LohanAtapattu/Unic_Cass_IHP/docs/bandpass_filter_topology.png

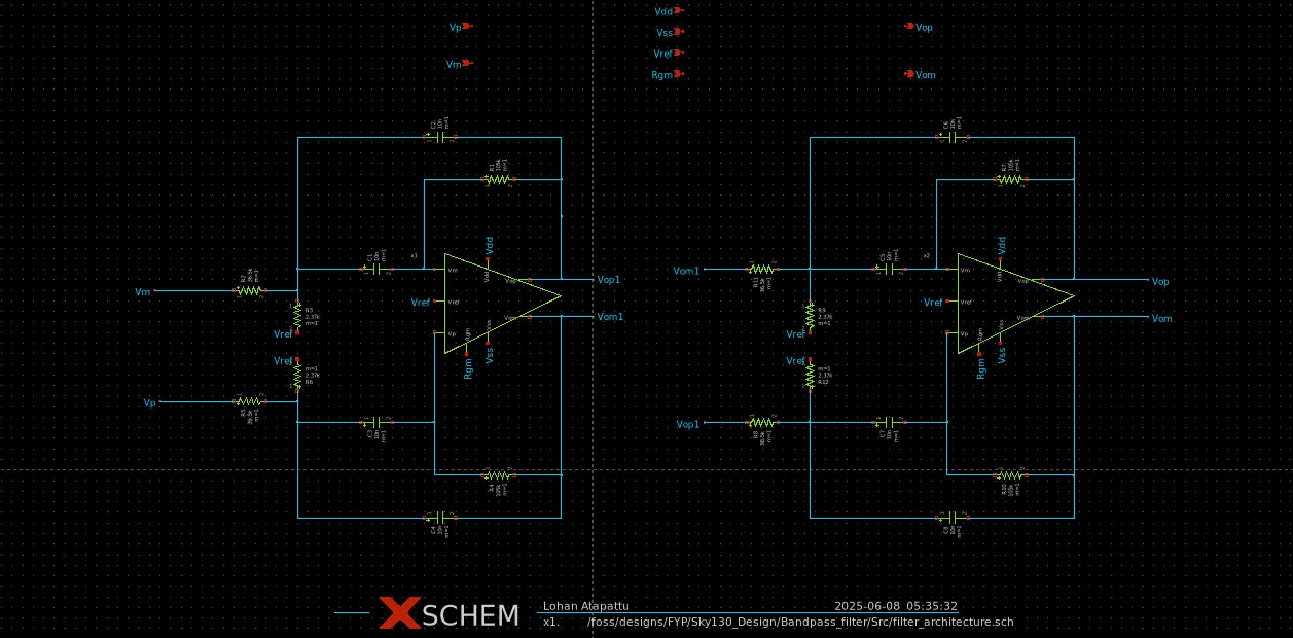
docs/bandpass_filter_topology.png
