LohanAtapattu/Unic_Cass_IHP/docs/cmrr_simulation.png

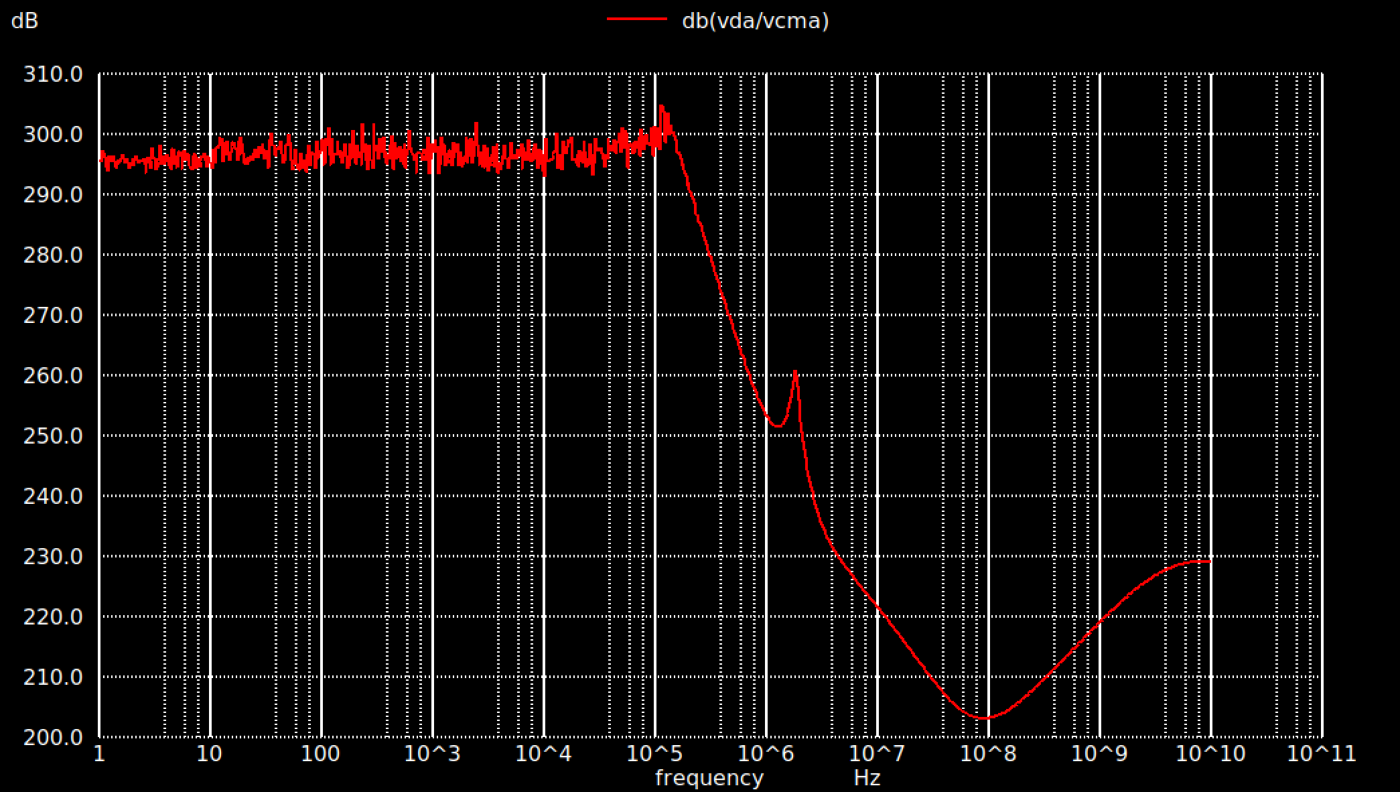
docs/cmrr_simulation.png
