LohanAtapattu/Unic_Cass_IHP/docs/Gain_Bandwidth_product.png

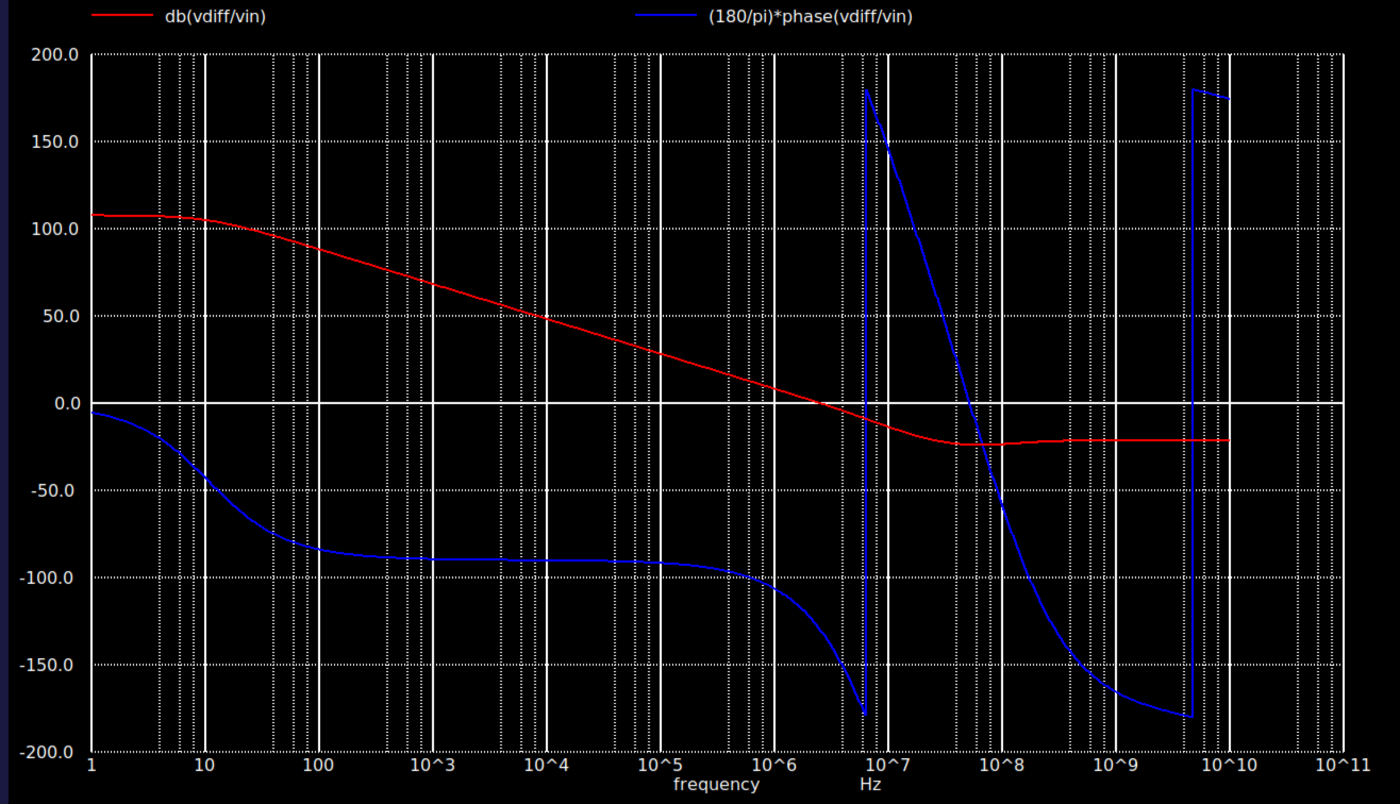
docs/Gain_Bandwidth_product.png
