LohanAtapattu/Unic_Cass_IHP/docs/Operational_amplifier.png

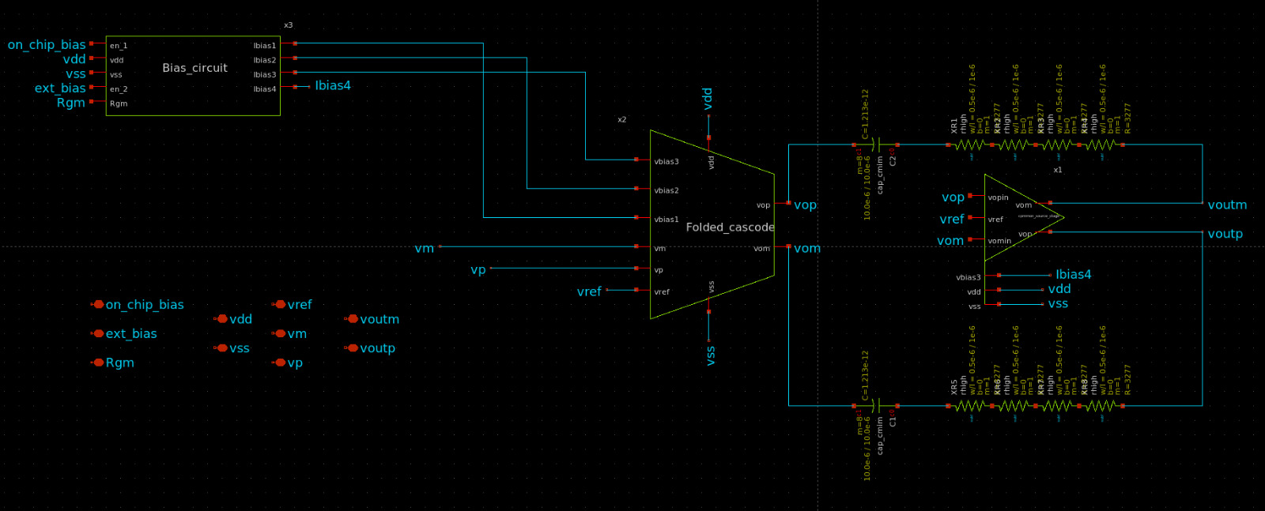
docs/Operational_amplifier.png
