LohanAtapattu/Unic_Cass_IHP/docs/bandpass_filter_testing_results.png

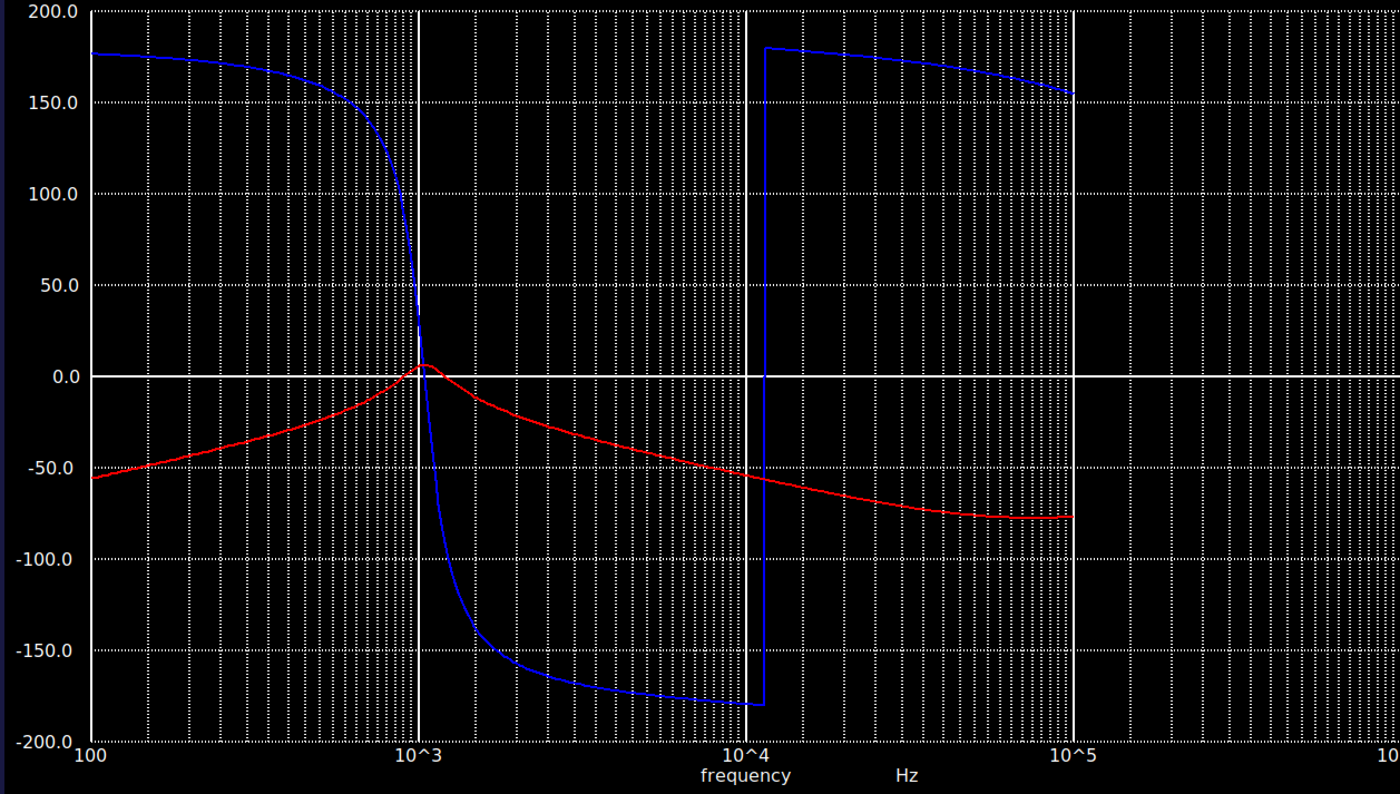
docs/bandpass_filter_testing_results.png
