LohanAtapattu/Unic_Cass_IHP/docs/impedance_measurement_ASIC.png

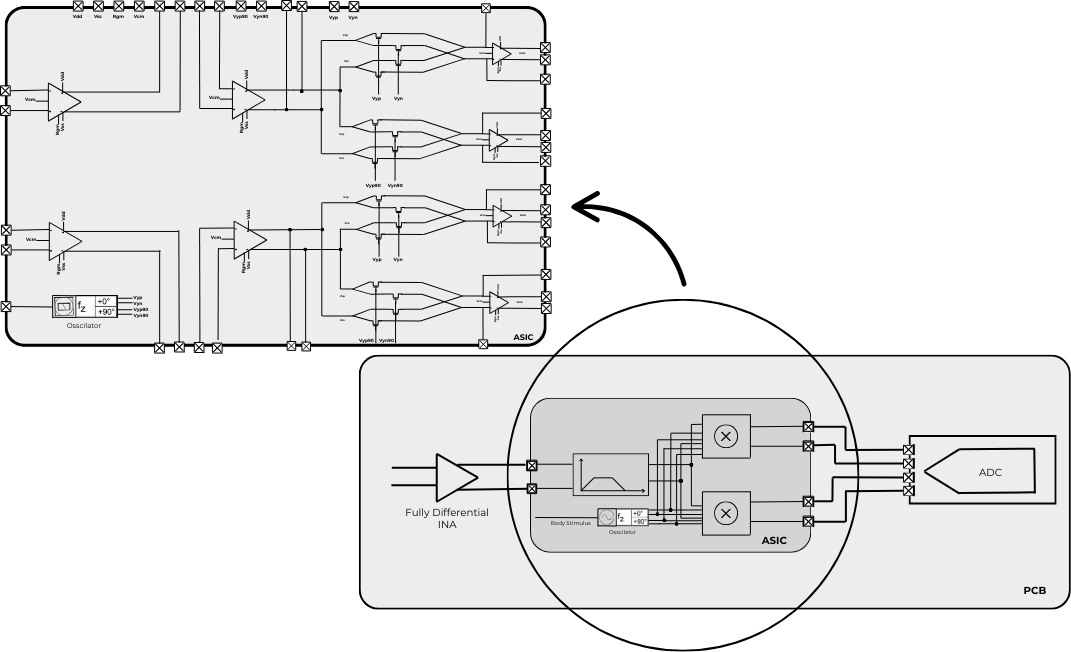
docs/impedance_measurement_ASIC.png
