LohanAtapattu/Unic_Cass_IHP/docs/linearity_test_bench.png

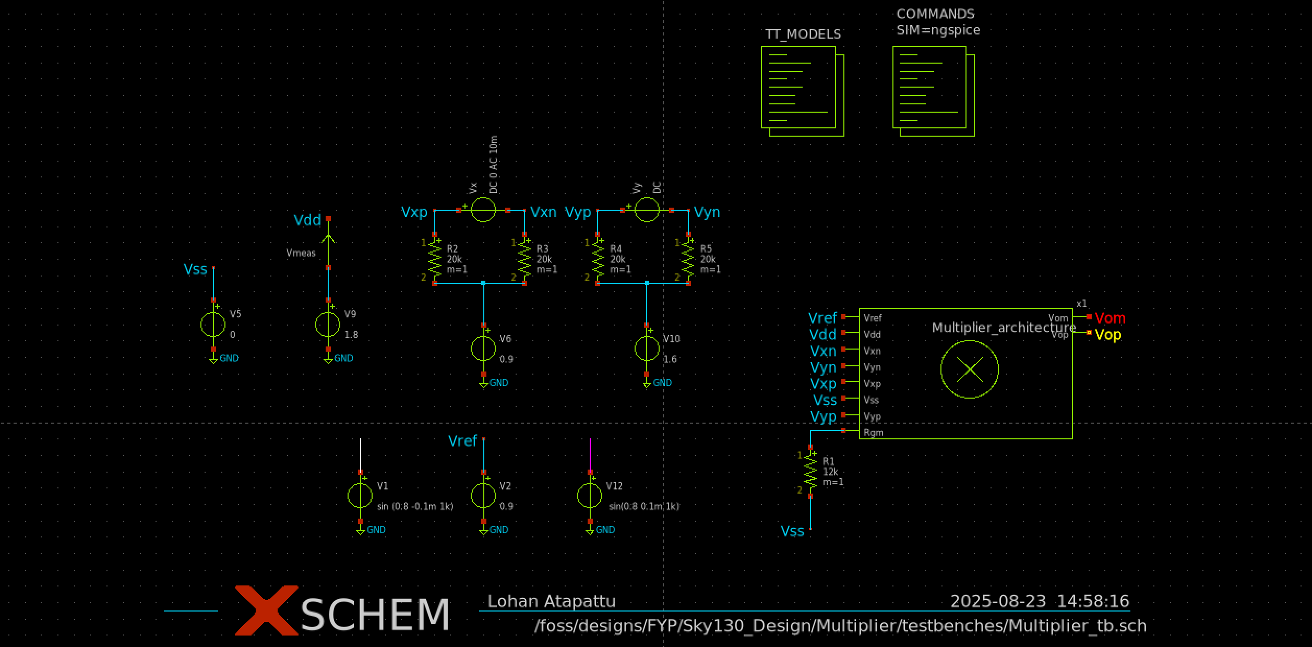
docs/linearity_test_bench.png
