LohanAtapattu/Unic_Cass_IHP/docs/pssr_test_results.png

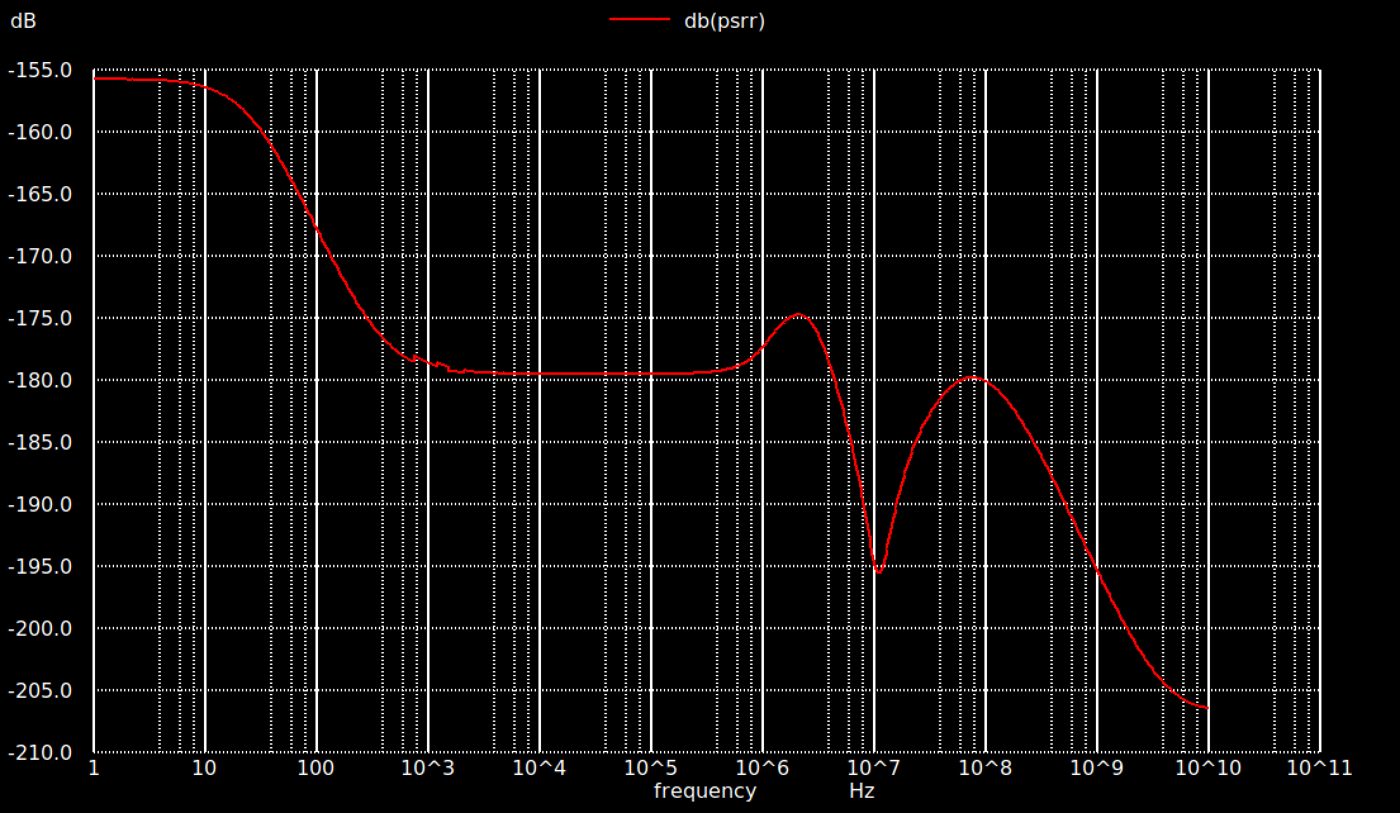
docs/pssr_test_results.png
