LohanAtapattu/Unic_Cass_IHP/(commit log)

2026-03-07 Uploaded LVS simulation results
    [Bias_circuit.sch, Folded_cascode.sch, Full_opamp.sch, common_source_stage.sch, cs_tb.sch, full_opamp_tb.sch, multiplier.sch, multiplier_tb.sch]
2026-09-15 Updated designs with clean LVS/DRC
    [Folded_cascode.sch, Full_opamp.sch, common_source_stage.sch, multiplier_top.sch]
2026-09-15 fix path issues in subcells.
    [Full_opamp.sch, common_source_stage.sch, multiplier_top.sch]
2026-09-16 changed the folded cascode op to opx and om to omx
    [Full_opamp.sch, common_source_stage.sch, multiplier_top.sch]
2026-09-17 Fixed top-port mismatch error
    [Full_opamp.sch, common_source_stage.sch, multiplier_top.sch]
